hgy043/lab-env-monitor/中控-recv/User/文件夹说明.txt

app:业务逻辑代码入口
ISR_callback:中断调用的函数，我们可以统一写到该文件中，目的：方便管理
