hgy043/lab-env-monitor/hardware/LoRa网关.jpg

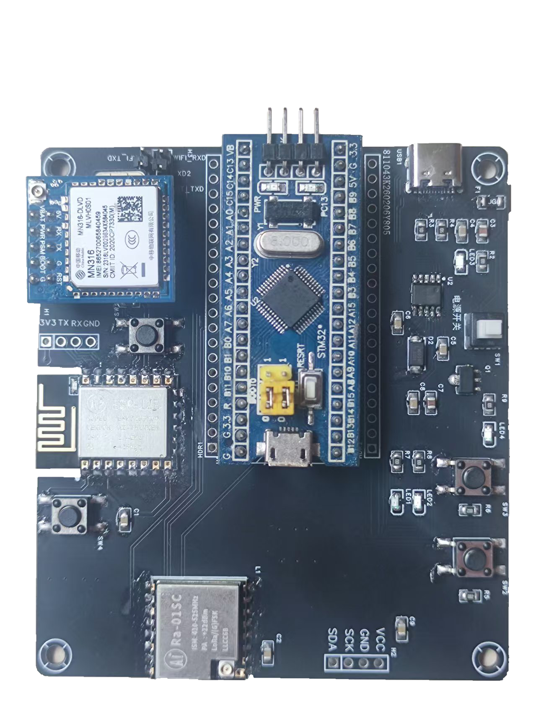
hardware/LoRa网关.jpg
