hgy043/lab-env-monitor/中控-recv/Core/Src/main.c

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
/* Includes ------------------------------------------------------------------*/
#include "main.h"
#include "i2c.h"
#include "spi.h"
#include "tim.h"
#include "usart.h"
#include "gpio.h"

/* USER CODE BEGIN Includes */
/*用户代码区->导入头文件#include "stdio.h"*/
#include "app_main.h"   //app_main() 的声明，不加会报 #223-D 隐式声明警告

/* USER CODE END Includes */

/* USER CODE BEGIN PTD */
/*用户代码区->定义类型（一般使用固定字节数类型，保证64/32都能正常）*/

/* USER CODE END PTD */

/* USER CODE BEGIN PD */
/*用户代码区->定义常量（pi或者其他系数）*/
#define RCC_APB2ENR    (*(unsigned int *)0x40021018)   
#define GPIOC_CRH      (*(unsigned int *)0x40011004)  
#define GPIOC_ODR      (*(unsigned int *)0x4001100C)

/* USER CODE END PD */

/* USER CODE BEGIN PM */
/*用户代码区->定义宏（可以将常用（高频）代码放入宏，
在预编译阶段插入，受编译器限制）
*/


/* USER CODE END PM */


/* USER CODE BEGIN PV */
//用户代码区->自定义全局变量


/* USER CODE END PV */

void SystemClock_Config(void);
/* USER CODE BEGIN PFP */
/*用户代码区->声明自定义函数（用户定义的私有函数声明）*/



/* USER CODE END PFP */

/* USER CODE BEGIN 0 */
/*这是一个“万能用户代码区”，最常见的是用来放置自定义函数的
实现（函数体）。当然，你也可以在这里定义只在本文件中使用的私有全局变量或宏。
*/

	

/* USER CODE END 0 */

/**
  * @brief  The application entry point.
  * @retval int
  */
int main(void)
{

  /* MCU Configuration--------------------------------------------------------*/

  /* Reset of all peripherals, Initializes the Flash interface and the Systick. */
  HAL_Init();

  /* Configure the system clock */
  SystemClock_Config();

  /* USER CODE BEGIN SysInit */
	//gpio_test();
	
	

  /* USER CODE END SysInit */

  /* Initialize all configured peripherals */
  MX_GPIO_Init();
  MX_USART1_UART_Init();
  MX_TIM1_Init();
  MX_USART2_UART_Init();
  MX_TIM4_Init();
  MX_I2C1_Init();
  MX_SPI1_Init();
  /* Infinite loop */
  /* USER CODE BEGIN WHILE */
	
		app_main();
	
	while (1)
  {
		
    /* USER CODE END WHILE */

    /* USER CODE BEGIN 3 */
			
  }
			
  /* USER CODE END 3 */
}

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
