hgy043/lab-env-monitor/中控-recv/Core/Inc/main.h

#define LORA_SPI_NSS_Pin GPIO_PIN_4
#define LORA_SPI_NSS_GPIO_Port GPIOA
#define LoRa_SPI_SCK_Pin GPIO_PIN_5
#define LoRa_SPI_SCK_GPIO_Port GPIOA
#define LoRa_SPI_MISO_Pin GPIO_PIN_6
#define LoRa_SPI_MISO_GPIO_Port GPIOA
#define LoRa_SPI_MOSI_Pin GPIO_PIN_7
#define LoRa_SPI_MOSI_GPIO_Port GPIOA
#define LORA_BUSY_Pin GPIO_PIN_0
#define LORA_BUSY_GPIO_Port GPIOB
#define LORA_SPI_RESET_Pin GPIO_PIN_1
#define LORA_SPI_RESET_GPIO_Port GPIOB
#define LORA_DIO1_Pin GPIO_PIN_10
#define LORA_DIO1_GPIO_Port GPIOB
#define LORA_DIO1_EXTI_IRQn EXTI15_10_IRQn
