hgy043/lab-env-monitor/中控-recv/User/oled/bmp.h

//////////////////////////////////////////////////////////////////////////////////	 
//
//
//存储图片数据，图片大小为64*32像素
//
/////////////////////////////////////////////////////////////////////////////////

#ifndef __BMP_H
#define __BMP_H
const unsigned char g_image_humi[288] = {
/* 48 x 48 BMP 格式的点阵数据 扫描方式：列行扫描 */
0x00, 0x00, 0x00, 0x00, 0x00, 0x00, 0x00, 0x00, 0x00, 0x00, 0x00, 0x00, 0x00, 0x00, 0x00, 0x00, 
0x00, 0x00, 0x00, 0x00, 0x00, 0xC0, 0xE0, 0xF8, 0xFC, 0xF8, 0xE0, 0x80, 0x00, 0x00, 0x00, 0x00, 
0x00, 0x00, 0x00, 0x00, 0x00, 0x00, 0x00, 0x00, 0x00, 0x00, 0x00, 0x00, 0x00, 0x00, 0x00, 0x00, 
0x00, 0x00, 0x00, 0x00, 0x00, 0x00, 0x00, 0x00, 0x00, 0x00, 0x00, 0x00, 0x00, 0x00, 0x00, 0x00, 
0x80, 0xE0, 0xF8, 0xFC, 0xFF, 0x3F, 0x1F, 0x07, 0x03, 0x0F, 0x1F, 0x7F, 0xFF, 0xFC, 0xF0, 0xE0, 
0x80, 0x00, 0x00, 0x00, 0x00, 0x00, 0x00, 0x00, 0x00, 0x00, 0x00, 0x00, 0x00, 0x00, 0x00, 0x00, 
0x00, 0x00, 0x00, 0x00, 0x00, 0x00, 0x00, 0x00, 0x00, 0x00, 0x00, 0x80, 0xE0, 0xF0, 0xFC, 0x7F, 
0x3F, 0x0F, 0x07, 0x01, 0x00, 0x00, 0x00, 0x00, 0x00, 0x00, 0x00, 0x00, 0x00, 0x03, 0x07, 0x1F, 
0x3F, 0xFF, 0xFC, 0xF0, 0xE0, 0x80, 0x00, 0x00, 0x00, 0x00, 0x00, 0x00, 0x00, 0x00, 0x00, 0x00, 
0x00, 0x00, 0x00, 0x00, 0x00, 0x00, 0x00, 0x00, 0x00, 0xF8, 0xFF, 0xFF, 0x3F, 0x03, 0x01, 0x00, 
0x00, 0x00, 0x3C, 0x62, 0x42, 0x62, 0x3C, 0x80, 0x60, 0x10, 0x8C, 0x82, 0x80, 0x00, 0x00, 0x00, 
0x00, 0x00, 0x01, 0x07, 0xFF, 0xFF, 0xFE, 0xF0, 0x00, 0x00, 0x00, 0x00, 0x00, 0x00, 0x00, 0x00, 
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
0xFF, 0xFF, 0xFF, 0xFF, 0xFF, 0xFF, 0xFF, 0xFF, 0xFF, 0xFF, 0xC7, 0xC3, 0x83, 0x87, 0xC3, 0xF3, 
0xFF, 0xFF, 0xDF, 0xC7, 0x83, 0x83, 0x83, 0x87, 0xFF, 0xFF, 0xFF, 0xFF, 0xFF, 0xFF, 0xFF, 0xFF, 
};

#endif
