hgy043/lab-env-monitor/中控-recv/User/oled/oledfont.h

#ifndef __OLEDFONT_H
#define __OLEDFONT_H 	   

#define FONT_SIZE_8		  0   // 0 / 8，字体高度8
#define	FONT_SIZE_16    16   // 0 / 16，字体高度16
#define	FONT_SIZE_24    24   // 0 / 24，字体高度24
#define	FONT_SIZE_32    0   // 0 / 32，字体高度32
#define	FONT_SIZE_40    0   // 0 / 40，字体高度40
#define	FONT_SIZE_48    0   // 0 / 48，字体高度48
#define	FONT_SIZE_64    0   // 0 / 64，字体高度64

const unsigned char Ferror[32] = {
  0xFF,0x01,0x01,0x01,0x31,0x09,0x09,0x09,0x09,0x89,0x71,0x01,0x01,0x01,0x01,0xFF,
	0xFF,0x80,0x80,0x80,0x80,0x80,0x80,0x96,0x81,0x80,0x80,0x80,0x80,0x80,0x80,0xFF,};  //16x16 框框+问号


#if FONT_SIZE_8
const unsigned char F6x8[][6] =		
{
    {0x00, 0x00, 0x00, 0x00, 0x00, 0x00}, // sp
    {0x00, 0x00, 0x00, 0x2f, 0x00, 0x00}, // !
    {0x00, 0x00, 0x07, 0x00, 0x07, 0x00}, // "
    {0x00, 0x14, 0x7f, 0x14, 0x7f, 0x14}, // #
    {0x00, 0x24, 0x2a, 0x7f, 0x2a, 0x12}, // $
    {0x00, 0x62, 0x64, 0x08, 0x13, 0x23}, // %
    {0x00, 0x36, 0x49, 0x55, 0x22, 0x50}, // &
    {0x00, 0x00, 0x05, 0x03, 0x00, 0x00}, // '
    {0x00, 0x00, 0x1c, 0x22, 0x41, 0x00}, // (
    {0x00, 0x00, 0x41, 0x22, 0x1c, 0x00}, // )
    {0x00, 0x14, 0x08, 0x3E, 0x08, 0x14}, // *
    {0x00, 0x08, 0x08, 0x3E, 0x08, 0x08}, // +
    {0x00, 0x00, 0x00, 0xA0, 0x60, 0x00}, // ,
    {0x00, 0x08, 0x08, 0x08, 0x08, 0x08}, // -
    {0x00, 0x00, 0x60, 0x60, 0x00, 0x00}, // .
    {0x00, 0x20, 0x10, 0x08, 0x04, 0x02}, // /
    {0x00, 0x3E, 0x51, 0x49, 0x45, 0x3E}, // 0
    {0x00, 0x00, 0x42, 0x7F, 0x40, 0x00}, // 1
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
  0x01, 0x01, 0x01, 0x03, 0x03, 0x07, 0x0F, 0x1F, 0x3F, 0x1F, 0x0F, 0x07, 0x03, 0x00, 0x00, 0x00, 
  0x00, 0x00, 0x00, 0x00, 0x00, 0x00, 0x00, 0x00, 0x00, 0x00, 0x00, 0x00, 0x00, 0x00, 0x00, 0x00, 
},
};
#endif

#endif
