hgy043/lab-env-monitor/中控-recv/User/bsp/led/led.c

#include "led.h"

//led流水灯的测试
void led_test1_ms(void)
{
	HAL_GPIO_WritePin(GPIOC, GPIO_PIN_13, GPIO_PIN_SET);
	delay_ms(500);
	HAL_GPIO_WritePin(GPIOC, GPIO_PIN_13, GPIO_PIN_RESET);
	delay_ms(500);
		
	HAL_GPIO_WritePin(GPIOA, GPIO_PIN_8, GPIO_PIN_RESET);
	delay_ms(500);
	HAL_GPIO_WritePin(GPIOA, GPIO_PIN_8, GPIO_PIN_SET);
	delay_ms(500);	

	HAL_GPIO_WritePin(GPIOB, GPIO_PIN_15, GPIO_PIN_RESET);
	delay_ms(500);
	HAL_GPIO_WritePin(GPIOB, GPIO_PIN_15, GPIO_PIN_SET);
	delay_ms(500);		
}

//led流水灯的测试
void led_test1_s(void)
{
	HAL_GPIO_WritePin(GPIOC, GPIO_PIN_13, GPIO_PIN_SET);
	delay_s(1);
	HAL_GPIO_WritePin(GPIOC, GPIO_PIN_13, GPIO_PIN_RESET);
	delay_s(1);
		
	HAL_GPIO_WritePin(GPIOA, GPIO_PIN_8, GPIO_PIN_RESET);
	delay_s(1);
	HAL_GPIO_WritePin(GPIOA, GPIO_PIN_8, GPIO_PIN_SET);
	delay_s(1);	

	HAL_GPIO_WritePin(GPIOB, GPIO_PIN_15, GPIO_PIN_RESET);
	delay_s(1);
	HAL_GPIO_WritePin(GPIOB, GPIO_PIN_15, GPIO_PIN_SET);
	delay_s(1);		
}

//led流水灯的测试
void led_test1_us(void)
{
	HAL_GPIO_WritePin(GPIOC, GPIO_PIN_13, GPIO_PIN_SET);
	delay_us(500);
	HAL_GPIO_WritePin(GPIOC, GPIO_PIN_13, GPIO_PIN_RESET);
	delay_us(500);
		
	HAL_GPIO_WritePin(GPIOA, GPIO_PIN_8, GPIO_PIN_RESET);
	delay_us(500);
	HAL_GPIO_WritePin(GPIOA, GPIO_PIN_8, GPIO_PIN_SET);
	delay_us(500);	

	HAL_GPIO_WritePin(GPIOB, GPIO_PIN_15, GPIO_PIN_RESET);
	delay_us(500);
	HAL_GPIO_WritePin(GPIOB, GPIO_PIN_15, GPIO_PIN_SET);
	delay_us(500);		
}
