hgy043/lab-env-monitor/中控-recv/User/bsp/led/led.h

#ifndef LED_MAIN_H	// 防止头文件重复包含
#define LED_MAIN_H


#include "main.h"
#include "gpio.h"
#include "app_main.h"


//led流水灯的测试
void led_test1_s(void);
void led_test1_ms(void);
void led_test1_us(void);

#endif
